SoulXHades/CZ3004-MDP-Arduino/README Images/Sharp-GP2Y0A02-300x300.jpg

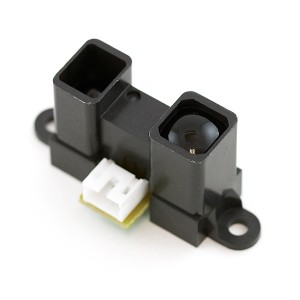
README Images/Sharp-GP2Y0A02-300x300.jpg
