SoulXHades/CZ3004-MDP-Arduino/Week 10 Actual Run Code/MDP/Sensor Calibration/SensorData.xlsx

For linear interpolation method
Sensor | Distance | IR Value | Sensor | Distance | IR Value | Sensor | Distance | IR Value | Sensor | Distance | IR Value | Sensor | Distance | IR Value | Sensor | Distance | IR Value
PS1 | 10cm | 301 | PS2 | 10cm | 407 | PS3 | 10cm | 270 | PS4 | 10cm | 325 | PS5 | 10cm |  | PS6
 | 15cm | 235 |  | 15cm | 292 |  | 15cm | 227 |  | 15cm | 247 |  | 15cm
 | 20cm | 201 |  | 20cm | 231 |  | 20cm | 187 |  | 20cm | 199 |  | 20cm
 | 25cm | 165 |  | 25cm | 188 |  | 25cm | 163 |  | 25cm | 175 |  | 25cm
