SoulXHades/CZ3004-MDP-Arduino/Week 10 Actual Run Code/MDP/mainProgram/motorMovement.ino

volatile double rpm_L; //rpm of left motor
volatile double rpm_R; //rpm of right motor
volatile double step_L; //number of steps taken by the left motor
volatile double step_R; //number of steps taken by the right motor
volatile double error; //difference between left and right steps

volatile const int SPEED =  250; //Set the speed of the motor

// PID Parameters
// PID values for obstacle avoidance checklist because interupt not working well due to delay checking the sensor: Kp=6, Ki=0, Kd=0.008
volatile double Kp=20, Ki=80, Kd=0; //Set PID values //Previous adjusted PID values: Kp=23, Ki=80, Kd=0.02 (When weight is one RPi and 2 powerbanks given PID values: Kp=30, Ki=80, Kd=0.02)
volatile double Output = 0; // Adjusted speed

// Create PID Instance
PID myPID(&rpm_R, &Output, &rpm_L, Kp, Ki, Kd, DIRECT);
/*Where parameters of the function are:
myPID(input(rpm), output(speed), setpoint(rpm), proportional value, intergral value, derative value, motor direction)*/

void forward(double gridNumber){
  
  double totalSteps = totalRegularSteps(getFinalSteps(gridNumber));

  motorStart();
  for(int i=0; i<=SPEED; i++){
    md.setSpeeds(i, i);
  }
  
  while (step_R <= totalSteps || step_L <= totalSteps ) 
  {
    computeRPM();
    myPID.Compute();
    error = step_L - step_R;
    double adjust = (error!=0) ? (error>0 ? 1 : -1) : 0;
    md.setSpeeds(SPEED + adjust + Output, SPEED - adjust);
  }

  motorStop();
  //delay(10);
  }

void backward(double gridNumber){
  // seperate number of ticks cause of the weight unevenness
  double totalSteps = totalRegularSteps(gridNumber * 8.9);
  
  motorStart();
  for(int i=0; i<=SPEED; i++){
    md.setSpeeds(-i, -i);
  }
  
  while (step_R <= totalSteps || step_L <= totalSteps )
  {
    //Serial.print(step_R); // debug
    computeRPM();
    myPID.Compute();
    error = step_L - step_R;
    double adjust = (error!=0) ? (error>0 ? 1 : -1) : 0;
    md.setSpeeds(-SPEED - adjust - Output, -SPEED + adjust);
  }

  motorStop();
  //delay(10);
  }

void leftTurn(double degree)
{
  double totalSteps = totalAngularSteps_L(degree);

  motorStart();
  for(int i=0; i<=SPEED; i++)
  {
    md.setSpeeds(i, -i);
  }
  
  while (step_R <= totalSteps || step_L <= totalSteps )
  {
    computeRPM();
    myPID.Compute();
    error = step_L - step_R;
    double adjust = (error!=0) ? (error>0 ? 1 : -1) : 0;
    md.setSpeeds(SPEED + adjust + Output, -SPEED + adjust);
  }

  motorStop();
  delay(75);
  }

void rightTurn(double degree)
{
  double totalSteps = totalAngularSteps_R(degree);

  motorStart();
  for(int i=0; i<=SPEED; i++){
    md.setSpeeds(-i, i);
  }
  
  while (step_R <= totalSteps || step_L <= totalSteps )
  {
    computeRPM();
    myPID.Compute();
    error = step_L - step_R;
    double adjust = (error!=0) ? (error>0 ? 1 : -1) : 0;
    md.setSpeeds(-SPEED - adjust - Output, SPEED - adjust);
  }

  motorStop();
  delay(75);
}

// calibrate robot to correct angle from the wall of front using front right (PS1) and front left (PS3) sensors
// if the angle is correct, both the readings shouldn't deviate much
double CaliAngle(bool firstTime, bool leftWall)
{
  bool firstCounter = true;
  double distDiff;
  double distDiff_retVal = 0;
  int count = 0;
  int calSPEED = 50;

  distDiff_retVal = getDistance(3) - getDistance(1);

  // only if all 3 are less than 3 grids away from a wall
  if (getDistance(3) < 30 && getDistance(4) < 30 && getDistance(1) < 30)
  {
    // used to check if the robot is facing a corner then might calibrate to the wrong position because left sensor and right sensor are detecting different walls.
    // using of the middle front sensor will allow us to know the robot is facing a corner as the middle front sensor will shoot the corner of the walls which will get higher distance than the front two side sensors
    while (getDistance(4) > getDistance(3) && getDistance(4) > getDistance(1))
    {
      // if there is a left wall, we can't confirm if the robot is facing corner between front and left wall or front and right wall (if there is a right wall too)
      // since have left wall, turn left to calibrate to the left wall 1st
      if (leftWall)
      {
        leftTurn(90);
        CaliAngle(true, false);
        rightTurn(90);
        // break cause should have calibrated correctly so no need to check if the robot is still facing a corner
        break;
      }
      else
        // when the robot is likely to face a corner of front wall and right wall
        leftTurn(10);
    }
  }

  // range that sensor is still roughly stable hence can use those values to calibrate
  while (getDistance(3) < 30 && getDistance(1) < 30)
  {
    // so won't have infinite loop as it will never be fully perfect
    if (count == 180)
    {
      // stop robot moving
      motorStop();

      // if got wall on the left of the robot, turn right a bit 1st
      if (leftWall)
        rightTurn(10);
      else
        leftTurn(10);

      count = 0;
    }

    // if different is a lot, means the robot is not perpenticular to the wall
    distDiff = getDistance(3) - getDistance(1);

    // too tilted to the left, turn to the right
    if (distDiff >= 0.05) 
      md.setSpeeds(-calSPEED, calSPEED);
    // too titled to the right, turn to the left
    else if (distDiff <= -0.05)
      md.setSpeeds(calSPEED, -calSPEED);
    // correct angle
    else
    {
      // stop the robot from moving
      motorStop();
      
      // calibrate angle again after moving (useful if robot was too far from the wall when calibrating angle causing angle calibration to be off)
      if (firstTime)
        caliDist(leftWall);
      break;
    }
  }

  return distDiff_retVal;
}

// Calibrate robot to targetDist from the wall of front using front right (PS1) and front left (PS3) sensors.
// Uses PS1 and PS3 cause there if those wall/obstacle exist for PS1 and PS3 to calibrate angle, 
//    it can too for distance calibration which there maybe be no wall/obstacle at PS2's direction
void caliDist(bool leftWall)
{
  bool tooMuch = false;
  bool tooLittle = false;
  bool overFlow = false;
  int SPEEDL = 100;
  int SPEEDR = 100;
  int count = 0;

  // infinite WHILE loop till it's completed
  while (1)
  {
    if(count == 1000 || overFlow)
      break;
    
    // if too far off, move closer
    if (getDistance(3) > 5.0 || getDistance(1) > 5.0)
    {
      md.setSpeeds(SPEEDR, SPEEDL);

      // helps prevent robot moving back and forward too many times till count == 1000 if the speed of the robot is too high preventing the robot from reaching the acceptable threshold. 
      if (tooLittle)
        overFlow = true;
      else
        tooMuch = true;
    }
    // if too close, reverse
    else if (getDistance(3) < 4.4 || getDistance(1) < 4.4)
    {
      md.setSpeeds(-SPEEDR, -SPEEDL);

      // helps prevent robot moving back and forward too many times till count == 1000 if the speed of the robot is too high preventing the robot from reaching the acceptable threshold. 
      if (tooMuch)
        overFlow = true;
      else
        tooLittle = true;
    }
    // within acceptable range, stop calibrating
    else 
      break;

    ++count;
  }

  // stop the robot from moving
  motorStop();

  // calibrate angle again after moving (useful if robot was too far from the wall when calibrating angle causing angle calibration to be off)
  CaliAngle(false, leftWall);
}

// alignment of robot to the starting position
void alignment()
{
  delay(1500);
  rightTurn(180);
  delay(100);
  CaliAngle(true, false);
  rightTurn(90);
  delay(100);
  CaliAngle(true, true);
  rightTurn(90);
  delay(200);
}


//////////////////////////////////////////////////// Obstacle avoidance checklist ////////////////////////////////////////////////////

// for obstacle avoidance checklist
void avoid(){
  PS2_obstacleDetection();

  if(PS2_value == 2)
  {
    if (secondAvoid)
      return;
    else
    {
      motorStop();
      delay(100);
      rightTurnTest(45);
      delay(100);
      forward(3);
      delay(100);
      leftTurnTest(45);
      delay(100);
      forward(5);
      delay(100);
      leftTurnTest(45);
      delay(100);
      forward(3);
      delay(100);
      rightTurnTest(45);
      motorStop();

      // hardcode stop before the end of the arena
      secondAvoid = true;
      }
  }
}

// for obstacle avoidance checklist
void forwardTest(){
  
  double totalSteps = totalRegularSteps(fifteen_grid);

  motorStart();
  
  for(int i=0; i<=SPEED; i++){
    md.setSpeeds(i, i);
  }
  
  while (step_R <= totalSteps || step_L <= totalSteps )
  {
    avoid();
    if(PS2_value == 2 && secondAvoid)
      break;
    computeRPM();
    myPID.Compute();
    error = step_L - step_R;
    double adjust = (error!=0) ? (error>0 ? 1 : -1) : 0;
    md.setSpeeds(SPEED + adjust + Output, SPEED - adjust);
  }

  motorStop();
  delay(10);
  }

void backwardTest(){
  double totalSteps = totalRegularSteps(fifteen_grid);

  motorStart();
  
  for(int i=0; i<=SPEED; i++){
    md.setSpeeds(-i, -i);
  }
  
  while (step_R <= totalSteps || step_L <= totalSteps ) {
  computeRPM();
  myPID.Compute();
  error = step_L - step_R;
  double adjust = (error!=0) ? (error>0 ? 1 : -1) : 0;
  md.setSpeeds(-SPEED - adjust - Output, -SPEED + adjust);
  }

  motorStop();
  delay(10);
  }

// for obstacle avoidance checklist
void leftTurnTest(double degree){
  
  double totalSteps = totalAngularSteps_L(degree);

  motorStart();
  for(int i=0; i<=SPEED; i++){
    md.setSpeeds(i, -i);
  }
  
  while (step_R <= totalSteps || step_L <= totalSteps ) {
  computeRPM();
  myPID.Compute();
  error = step_L - step_R;
  double adjust = (error!=0) ? (error>0 ? 1 : -1) : 0;
  md.setSpeeds(SPEED + adjust + Output, -SPEED + adjust);
  }

  motorStop();
  delay(10);
}

// for obstacle avoidance checklist
void rightTurnTest(double degree){
  double totalSteps = totalAngularSteps_R(degree);

  motorStart();
  for(int i=0; i<=SPEED; i++){
    md.setSpeeds(-i, i);
  }
  
  while (step_R <= totalSteps || step_L <= totalSteps ) {
  computeRPM();
  myPID.Compute();
  error = step_L - step_R;
  double adjust = (error!=0) ? (error>0 ? 1 : -1) : 0;
  md.setSpeeds(-SPEED - adjust - Output, SPEED - adjust);
  }

  motorStop();
  delay(10);
}
