SoulXHades/CZ3004-MDP-Arduino/(commit log)

2020-03-06 MDP
    Included dynamic angular calibration function at the start before the run but not implemented yet.
2020-03-06 MDP
    Calibrate the optimal angle for 2nd battery when it is fully charged.
2020-03-06 MDP
    1. Calibrated the angle again
    2. Fixed long range sensor's code bug
    [distanceCalibration.ino, mainProgram.ino, motorMovement.ino, sensor_calibration.ino]
2020-03-06 MDP
    1. Adding alignment of robot to start position to SWITCH CASE (allowing Algo PC) to request for alignment of robot.
2020-03-06 MDP
    1. Change of speed, counter, and threshold of distance auto calibration
2020-03-06 MDP
    1. Recalibrated the 1 grid distance value to higher value to overcome robot skidding issue.
    [distanceCalibration.ino, mainProgram.ino]
2020-03-06 MDP
    1. Increased counter for angular calibration loop.
2020-03-09 MDP
    1. Calibrated IR sensor PS5
    2. Added new command: Move backwards 1 grid (case 'D', case'd')
2020-03-09 MDP
    1. Change the newly calibrated angle
    2. Changed the forward distance to lesser so won't overshot 1 grid after 18 grids of moving straight with no calibration forward.
    [distanceCalibration.ino, mainProgram.ino]
2020-03-10 MDP
    1. Recalibrated PS2 sensor.
    2. Added additional command 'E': Turn right, send sensor data, turn back left
    3. Added additional command 'G': Keep going while send sensor data till sense obstacle infront
2020-03-10 MDP
    Commented the debug printing of right motor ticks so won't send to RPi that data.
    [motorMovement.ino]
2020-03-10 MDP
    1. Update of command 'G' bug and optimized the code of command 'G'.
    [mainProgram.ino, sensor_calibration.ino]
2020-03-11 MDP
    1. Swap PS2 and PS4 sensors
    2. Recalibrated PS2 and PS4 sensors
    [sensor_calibration.ino]
2020-03-11 MDP
    1. Added calibrate front and right
    2. Added calibrate right
    3. Added calibrate front or left or front and left followed by sending sensor data of the right of the robot since right long sensor is not reliable.
2020-03-11 MDP
    1. Added more delays before turning and after turning
    2. Recalibrated right turning
    3. Change the algo for calibration
    4. Fixed some bugs at SWITCH case for commands where there are missing 'break;'
    [distanceCalibration.ino, mainProgram.ino, motorMovement.ino]
2020-03-11 MDP
    1. Added sending of sensor data after calling 'F' command
2020-03-11 MDP
    Recalibrated IR sensor library offsets
2020-03-12 MDP
    Added extra power bank onto the robot to prevent skidding.
    Now consist of 1 RPi and 2 given powerbank. Due to the weight, we needed to recalibrate.
    1. Change in PID
    2. Changed in grid 1 ticks
    3. Special number of ticks for 1 grid of backwards.
    4. Calibrated the angle for left turn
    [distanceCalibration.ino, mainProgram.ino, motorMovement.ino]
2020-03-12 MDP
    1. Calibrated angular turns of both side
2020-03-12 MDP
    1. Recalibrated the angle according to the stable voltage.
2020-03-12 MDP
    1. Eiminated bugs for fastest path.
    [mainProgram.ino]
2020-03-13 MDP
    1. Recalibrated the angles right before leadership board run.
2020-03-16 MDP
    -Adjusted SPEED to 330
    -Adjusted grid, angular values
    -Changed PID values
    -Reduced SAMPLE_SIZE to 11
    -Commented out extra serial print
2020-03-16 MDP
    1. Added motorstops to the calibrate angle
2020-03-18 MDP
    1. Recalibrated distance and angle of turning
    2. Allows toggling of additional speed for right motor for 1 grid during exploration vs many grids
    3. Increased sample size to 16 for accuracy
2020-03-18 MDP
    1. Upload back the original code for the actual run
    2. Implemented overflow checker for distance calibrate to prevent robot from shaking too much back and forward during distance calibration if cannot hit acceptable threshold in caliDist()
    [mainProgram.ino, motorMovement.ino]
2020-03-19 MDP
    1. Coded some algorithm to overcome stuck for angle. Commented it as it has not been tested if it will work.
    [motorMovement.ino]
2020-03-19 MDP
    -SPEED changed to 320
    -Adjusted addSPEED_R for both cases (1 by 1 step and continuous steps)
    -AngularSteps adjusted according to battery voltage of >6.3V
2020-03-19 MDP
    1. Rollback to week 8's code for week 9's run
    2. Added improvements code to the calibration which was implemented on the supposing week 9's code to the week 8's code
    3. Week 9's supposing code result in robot to skid hence we rollback back to week 8's code but with some improvement.
    4. Fixed the dynamic calibration bug and also improve the precision with more loops for week 8's code to be use in week 9's run.
    [SensorData.xlsx]
2020-03-20 MDP
    Week 9's actual code
    1. Recalibrated the turning.
    2. Commented away the dynamic calibration
2020-03-20 MDP
    1. Put week 9's actual run code in another folder
    [SensorData.xlsx]
2020-03-23 MDP
    1. Just commented away the print debug for sensor so RPi will stop receiving it
    2. Added solution to counter calibration issue when robot is facing a corner between walls
    [motorMovement.ino, sensor_calibration.ino]
2020-03-24 MDP
    1. Added the calibration corner solver issue
    2. Commented away the dynamic calibration cause the robot keep moving left then making calibration not accurate if keep turning. each offset will become different
    3. Added paper to the right motor. Now more contact. So less skidding. Recalibrated a new PID and turning angle. Now is moving too much forward so need to calibrate the number of ticks moving forward.
    [distanceCalibration.ino, mainProgram.ino, motorMovement.ino]
2020-03-25 MDP
    1. Change long range sensor to more inwards and now at Right Left position
    2 recalibrated ps6 sensor
    3. changes the number of ticks for 1 grid, and backwards 1 grid
    4. recalibrated turning
    5. changed PID value
2020-03-25 MDP
    1. Recarlibrated the PID
    2. Removed right turn since we moved the sensor inwards to Right Left. So the PS6 long range sensor is now more realiable and no need right turn to get readings anymore.
2020-03-26 MDP
    1. Update of grid values to reduce them cause too much on the leadership board's arena.
    2. Increase precision of dynamic angular calibration
    [distanceCalibration.ino, mainProgram.ino]
2020-03-26 MDP
    1. Changing the dynamic angular calibration values cause max it can go is only 2d.p anyway so reduce the number of times it turns to calibrate and offset.
2020-03-26 MDP
    1. Reduced the number of dynamic angular calibration counter.
2020-03-27 MDP
    1. Modified number of ticks to lesser for one and 2 grids.
    2. Code is for Week 10's leadership board run
    3. Created another folder for week 10's leadership board run.
    4. Week 10's run is the best with successful exploration and fastest path. Full accuracy for exploration.
    [SensorData.xlsx]
